markmaker/PushPullFeeder/README.md

# PushPullFeeder
All 3d-Printed Tape&amp;Reel Feeder



See [the blog](https://makr.zone/?p=399).

Electrolize-Regular.ttf: Copyright (c) 2011, Cyreal (www.cyreal.org) 
with Reserved Font Name "Electrolize" This Font Software is licensed 
under the SIL Open Font License, Version 1.1. This license is available 
with a FAQ at: http://scripts.sil.org/OFL

See also:
https://github.com/google/fonts/tree/master/ofl/electrolize
