markmaker/PushPullFeeder/(threads)

Thread 1 (2020-12-07):

Reel holder axel too tight

scott-t-wilson, 2020-12-07:
After some testing I've determined that my best value for 'axel_play' is 0.02mm, but the reel holder/counterpart axel is not affected by that parameter.

Looks to me like lines 2401-2 should be changed from:

    cylinder_p(d=reel_axle-2*reel_axle_wall,
        h=reel_width+reel_holder_thickness+6*e);

to

    cylinder_p(d=reel_axle-2*reel_axle_wall+axle_play,
        h=reel_width+reel_holder_thickness+6*e);

scott-t-wilson, 2020-12-07:
Created a pull request to make things easier if you decide this is an appropriate problem/solution.

Thread 4 (2021-07-05):

One of the 3D printed pieces is not used for anything?

brainstorm, 2021-07-05:
In the GIF animation from the README.md, the piece circled in red in this issue seemingly serves no purpose? Can you elaborate why it was (is?) used for?:

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

We were quite puzzled while putting the pieces together XD

/cc @cpgmoore

markmaker, 2021-07-05:
Hi @brainstorm

That's not normally used. I just added it to support the full EIA 481 standard. According to the standard, the reel (the hub) can be very wide. It seems they were often made from thick cardboard in the past. If the full EIA 481 width of the reel is used, then that counter nut and hanger thingy (image below) does not fit into the feeder slot width I wanted not to exceed.

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

You then have to rely on the reel being held on one side only and the next feeder keeping it from falling off. In that case, there is nothing holding the spent tape spool. **Then this little part comes into play.**

I frankly don't expect to encounter many reels that use the full width. But they do seem to exist, see here:

https://groups.google.com/g/openpnp/c/y1X3I8l31vM/m/DZQb2gLvAQAJ

_Mark

brainstorm, 2021-07-05:
Epic response, thanks Mark, good to know if we encounter those ;)

Closed 2021-07-05.

Thread 5 (2021-10-03):

Provide basic stl files for 8mm

noeldum, 2021-10-03:
Great project. It would be nice to provide some stl file for the basic setup in 8mm. That would make your project more accessible to all of us.

Opening openscad for the first time in my life and would prefer just printing it for testing before spending time to learn openscad.

Managed to get all parts in one stl but struggling to split them into several individual stl files.

markmaker, 2021-10-03:
Hi @noeldum

> Great project.

Thanks.

> It would be nice to provide some stl file for the basic setup in 8mm.

I don't think that'll work. You really need to adjust the play etc. for your printer/filament. That adjustment is the price you need to pay for it to work without using screws etc.

>  before spending time to learn openscad.

You don't really need to know OpenSCAD. You just set the parameters in the Customizer. Watch the video.

>Managed to get all parts in one stl but struggling to split them into several individual stl files.

You can enable individual parts there.

Sorry for the short answer, gotta go now.

_Mark

Thread 6 (2021-12-21):

Parametrized packing of pieces?

brainstorm, 2021-12-21:
I wish there was some sort of (randomized? parametrized?) bed area packing option in this PushPullFeeder to fit those components (other than the current two phase system)... I'm sure I can print all the pieces below on a [Replicator+ bed size](https://www.makerbot.com/3d-printers/replicator/) in one go? This one was so close!:

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

markmaker, 2021-12-22:
Hi @brainstorm
On my PrusaSlicr (Slic3r) I can let it break up the model and rearrange it.
_Mark

brainstorm, 2021-12-22:
True that, pity that Makerbot's software does not seem to have an (obvious?) "split" option like Slic3r does :-S

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

I'll go ahead and jump through that splitting w/ slicer and re-import the resulting stl to the Makerbot Print software.

markmaker, 2021-12-23:
Just out of curiosity. Can't you use Slic3r directly on the Makerbot printer? Does the slicer really need to be specific to the printer?

markmaker, 2021-12-23:
I just downloaded Slic3r to see what's the difference to PrusaSlicer and it seems day and night:

This is the result of the auto-arrange in Slic3r:

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

This is the result of the auto-arrange in PrusaSlicer:

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

**NOTE**: you need to switch to **Configuration / Mode / Expert** for the **Split to Objects** command to become available.

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

I recommend using PrusaSlicer, obviously ;-)

_Mark

brainstorm, 2021-12-25:
Thanks Mark for sharing your tests and tribulations! Very instructive and interesting as always ;)

The reason I was going for Makerbot alone was twofold:

1) I'm preparing the 3D print job for [an external service (I don't own that printer)](https://eng.unimelb.edu.au/telstra-creator-space/3d-printing-at-telstra-creator-space), so I just wanted to stick with their "Standard Operating Procedure" and settings to avoid any possible issues.

2) Since I might be iterating and submitting this job (or parts of it) in the future after some further tweaks, I thought about minimizing the steps (and third party programs) to go through for each iteration.

Also as a curiosity, I'm preparing the same job for another [makerspace](https://github.com/CCHS-Melbourne/) and Cura isn't good either packing the pieces together:

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

So given that every other slicer/software does or doesn't do it well, I thought about having it done on the OpenSCAD side instead, but of course I don't want to put that burden of you, this is pure fun/hobby ;)

markmaker, 2021-12-25:
I understand and yes, doing it right out of OpenSCAD _is_ the best option, that's obviously what I did for my Prusa printer too.

I don't think it will be possible to write a generic auto-layouter inside OpenSCAD (that's quite a hard problem anyways). Instead I would simply aim for a more compact layout that fits on these smaller print beds. The layout implemented now (for Prusa) has just evolved along with the model, there was no big effort into optimization.

I'll certainly accept a PR.  ;-)

I must say I'm a bit surprised that these print services have smaller print beds. I always thought the Prusa was one of the  smaller printers.

Another option might be somehow scripting / command-line controlling PrusaSlicer.

_Mark

brainstorm, 2021-12-27:
> I'll certainly accept a PR. ;-)

Challenge accepted ;)

I guess I'll start by tweaking that translate piece by piece (otherwise it takes too long to render and iterate on it):

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

I guess that after putting a few magic numbers in those `translates` by adding offsets there manually I might find a way to generalise this well, but I'm not too sure it can easily 🤔

brainstorm, 2021-12-27:
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

Getting there, I'll keep tweaking... thinking about the pieces, most of them parametrize by height (inset, chute, base plate), so the packing can be fairly static and benefit everybody without many constraints or breakage at all :)

t-paul, 2021-12-28:
I suppose I can't claim an unbiased opinion, but I'm not sure OpenSCAD is the right place to do that. The main argument being that usually the Slicer is the tool that understands the geometry and restrictions of the printer. And that is not necessarily just the bed size. Depending on the printer setup / fabrication method, there could be additional constraints or more relaxed options (e.g. the [3DPrintMill](https://www.creality.com/goods-detail/creality-3dprintmill-3d-printer) could just print all objects in a line).

I think a good option would be extended support for generating multiple parts in OpenSCAD and export those in file formats supporting that (e.g. 3MF). Now that is out of control of an OpenSCAD script at this point, so some added support in the script could be a good short term solution. I only want to highlight a possible more general option in case someone has suggestions on how to tackle those :grinning:.

brainstorm, 2021-12-28:
Always nice to have an OpenSCAD dev popping by (from https://github.com/openscad/openscad/issues/4022) :D

I hear what you say, my intention was to tighten the iteration loop while printing... out of curiosity, I exported the scad model to .3MF (supported in OpenSCAD), but apparently MakerBot print doesn't seem to accept it as-is (.3MF file is grayed out as opposed to .STL)?

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

What do you mean by "added support in the script"? Are there special OpenSCAD directives for .3MF exports?

t-paul, 2021-12-28:
Yes, if there's reasonable effort options in the script, that's certainly a quicker win. Bigger export changes in OpenSCAD probably will take some time, even though it's a topic coming up repeatedly and it would be an extremely useful extension, not just for 3MF.

I've never used the Makerbot tools, but if those do not support 3MF, that's a very sad situation. Especially considering 3MF is not a new format anymore (published in 2015) and Stratasys is listed as Steering Member of the [3MF Consortium](https://3mf.io/). I don't know, maybe they insist using their proprietary "Thing" format which I've never seen supported anywhere else.

brainstorm, 2021-12-28:
Did a quick search and no, they (Makerbot) don't support .3MF, I also think it's a bit of a shame: https://twitter.com/braincode/status/1475906583347429376

Anyway, thanks both for your valuable feedback, I think I'll call it quits with PR #7, @markmaker, you both have very good points on not doing this in OpenSCAD, I'll go with slic3r for now ;)

brainstorm, 2021-12-28:
Last fun bit... it takes some creative packing to print all pieces on the Ender 3 v2 (Pro) bed:

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

Closed 2021-12-22.

Thread 10 (2022-02-07):

Detect presence/absence of component in reel via CV to avoid chute jamming?

brainstorm, 2022-02-07:
The nozzle tip computer vision pipeline in OpenPnP has a nice feature where the camera can detect if a nozzle tip is present or absent in the "holding rack" via empty vs occupied images: https://github.com/openpnp/openpnp/wiki/Nozzle-Tip-Changer#vision-calibration

I know that there are mechanisms such as vacuum sensing to tell if a component has been picked up or not successfully by the nozzle tip, but I was wondering if the pushpullfeeders could have the **vision** reliability checks to avoid mis-picks and subsequent jamming towards the chute?:

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

OTOH, the feeder does not usually jam, but I guess that it might eventually jam given a big enough accumulation of components in some parts of the chute...

brainstorm, 2022-02-09:
> But if you have that condition, what happens in bottom vision? Are these cases not caught by the missing parts?

Oddly enough, the bottom vision does recognize resistors (by the bounding rectangle drawn around), but when there's a miss-pick and the bare nozzle looks at the bottom camera, the Job continues as if everything was fine and it tries to place even when there's no resistor to be placed :/

/cc @PancakeLegend

markmaker, 2022-02-09:
That's odd. It should definitely not happen. Pipeline?

markmaker, 2022-03-11:
I think we agreed that the problem should be detected in the alignment, so I can close this here.
_Mark

Closed 2022-03-11.

Thread 9 (2022-02-07):

Adding more wings to the friction wheel affects spool fitting?

brainstorm, 2022-02-07:
The orange wheel has more edges than the simple hexagon of the first two blue and red friction wheels:

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

Therefore the previously printed spools do not have an optimal fit... although they coincidentally work fine, I just wanted to report this since I think it's a bug... the nut that locks with the spool should be an hexagon, independently of the number of wings from the friction wheel, IMHO.

In other words, adding more wings to the wheel would make the wheel-to-spool interface more unreliable since it'd eventually converge towards a circumference which could slip... keeping the hexagon shape irrespective of the number of wings would help.

Also, spoiler, the latter one is the difference of getting our feeders to work properly without retractions or not. The amount of wings on the orange piece is the one that makes our feeders work the most consistently with 0603 component reels.

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

markmaker, 2022-02-07:
Just also wanted to add that I'm well aware that the reliability of the friction wheel is the Achilles heel of the whole feeder. Each filament change required me to adapt its settings. I always managed to get it working, but it is definitely not "print and forget".

Anything to make it better is highly welcome. 👍👍👍

brainstorm, 2022-02-09:
I'll try to carve out some time and fix this hexagon issue, but it's actually not too critical, the wheel holds in place fine for now because the tolerances are good enough (for the testing we've been conducting so far and the use they've seen).

@PancakeLegend was theorizing on using magnets instead, but I'm not exactly sure how that'd work plus it introduces non-3D printed parts, which is not as practical as a fully 3D printed feeder.

OTOH a redesign/version of this feeder for laser cutting would be amazing because it'd cut down the manufacturing time greatly, but I massively digress here X"D

Closed 2022-07-30.

Thread 12 (2022-03-10):

Adjusting width of tape inset slot

infinitemachinery, 2022-03-10:
The slot for the tape in the tape inset is too snug in width. Some of the 8mm tapes I have will not even fit. What would be the correct parameter to adjust to slightly increase the width in the inset? Tape_width is not the one, as that appears to only be for the standard sizes 8,12,16, etc.

markmaker, 2022-03-11:
Hi @infinitemachinery

You're right, there isn't an actual parameter for that. It was never a problem so far, as the inset is one-sided and when pushing it to the body, I was able to make it a bit more or less tight.

But I see the need and I'll add it.

_Mark

markmaker, 2022-03-11:
See #13.

Closed 2022-03-11.

Thread 17 (2023-02-01):

Parts don't fit

tufelkinder, 2023-02-01:
I exploded this into parts using the OpenSCAD and printed it on my Original Prusa and none of the parts fit together. I pounded a couple together to make them fit and ultimately they just broke off. What am I likely doing wrong...?

markmaker, 2023-02-01:
Hi @tufelkinder

Please watch the video:
https://youtu.be/cNCjjvCT4Fc

Especially the part about adjusting the play using the test print:
https://youtu.be/cNCjjvCT4Fc?t=78

This project makes it a _design goal_ not to require screws, springs etc. so everybody can just print it without ordering parts. But this only works if you adjust the play to your printer, filament and settings.

_>  ultimately they just broke off_

Just in case you missed this: this project was developed for PETG, it will certainly **not** work with PLA.

See also here about the goals and features:
https://makr.zone/new-all-3d-printed-tapereel-feeder/399/

_Mark

tufelkinder, 2023-02-01:
Thank you, hadn't seen this Youtube video previously, so that's obviously very helpful.

For what it's worth, they broke off under extreme pressure and strain to connect and move the pieces. Still, I can look at switching to PETG.

markmaker, 2024-11-17:
I am closing this for now. If issues remain, we can always reopen it.

Closed 2024-11-17.

Thread 18 (2024-10-20):

New LumenPNP Needs Notch

AmeNote-Michael, 2024-10-20:
The new LumenPNP with their electronic feeders have added a backing positioning plate for their feeders to match their electronics. This adds requirement for a notch in the mount.

Love your PushPull Feeders. I am just tuning to use with my LumenPNP and look forward to having all my components on feeders. Strip feeders are just a pain and although I have a bunch of the LumenPNP feeders, I cannot afford for every component.

Could you add option for notch to support the new mounting of the LumenPNP. The image provided hopefully gives you all details needed for the notch. I am glad to test print and fit.

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

AmeNote-Michael, 2024-10-20:
By the way, the dimensions provided are in mm.

AmeNote-Michael, 2024-10-20:
For overhang, you will likely need to print in supports that need to be cut out.

AmeNote-Michael, 2024-10-20:
Just realized I could provide you the overall dimensions of the additional tabs on back of 2020 x member. It is 5mm deep by 5mm wide.

markmaker, 2024-10-20:
See #19 for a combined answer.

_Mark

markmaker, 2024-11-17:
See #19.

Closed 2024-11-17.

Thread 19 (2024-10-20):

Lever does not position on build Plate when subtract from extrusion mount edge

AmeNote-Michael, 2024-10-20:
To use LumenPNP existing extrusion mount, the extrusion mount edge y needs to be changed to -35. Doing so causes the default build plate print postion for the Lever to be inside the base part. Simple to fix by rendering seperately, but would be nice if can just generate.

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

markmaker, 2024-10-20:
Hi @AmeNote-Michael,

this answer includes #18.

Unfortunately, your -15mm adjustment of **extrusion mount edge y** is way more than I ever anticipated. As you see it also renders the tape chute cutout wrongly, i.e., it would be blocked like that we would need to improve from the simplistic way it is currently done. Maybe you don't want the chute at all, then we would need a way to disable it entirely, so it won't do the cutouts at all, and waste print time.

Trying to reconstruct your case, I also have problems with the lock lever cutouts (cut in two). You somehow seem to have overcome this, by adjusting more params, right? I fear such large changes would require many test-prints and much tuning until everything is peachy again. I'm not saying it can't be done, but you would need to be ready to invest that kind of time, effort and filament.

Making the base so much larger will also increase your print time per feeder significantly. I spent an eternity making everything as small as possible to bring it down.

Furthermore, I doubt you'll make it still fit one standard print platter, which is an important design goal too. Maybe if you leave out the chute, but then the design is not really complete, i.e., while you might be happy with this, the next user might not (which taints this option in the "Open Source" spirit a bit).

Your #18 requirement adds more problems to these. Including, as you guessed, need for 3D printing supports, which were entirely avoided in the main design so far. Again much thinking went into how to achieve that.

With #18 you also force the feeders to align with the notches. I haven't found specs, but assume the feeder is quite wide if a 12mm option exists with the same notches. If the push-pull feeders are narrower at their < 16mm, you'll waste space, i.e., the number of feeders you can add. And you'll lose some stability. The feeders are thought to really snuggle close to each other to add stability and to dampen some vibrations.

All-in-all I'd like you to consider another option:

Seeing the Lumen has two feeder banks, you could dedicate one to PushPullFeeders, or even just a part of one. Then mount another 20x20 V-slot extrusion on top of the feeder rail. Just some holes through it and then [drop in tee nuts](https://openbuildspartstore.com/drop-in-tee-nuts-pack/) in the lower rail, and screw down (countersunk).

This will even add to the stability of the frame. Vibrations from the push-pull actuation are a potential problem with 0402 parts, I needed to support my 20x20 extrusion every ~200mm for it to work all across.

Finally mount the mostly unmodified, proven PushPullFeeder on top. Given your -15mm Y adjustment, I assume you'll get a +5mm pick Z. This is not super-optimal, but still okay. With some careful tuning it could probably be reduced down a few millimeters.

You can always remove the extrusions on top, e.g. once you can afford more electric ones. With the drop in tee nuts, nothing is permanently modified or damaged on your machine.

What do you think?

_Mark

AmeNote-Michael, 2024-10-20:
Mark, thanks for quick reply. I had considered your option and looked into getting the materials as you suggested. I was thinking the bounce might be an issue, but your suggestion of several t bolts is a good idea. Will look at that. I am planning to use rear feeder bar for electronic and front feeder bar for push pull. Leaves a small build plate though, especially with my version of LumenPNP. Going to look into if I can mod mine to the latest version from Lumen which mounts the air pumps and electronics on side.

I like the idea of having a mix of feeders, depending on project. Use the Lumen feeders for components that exist pretty much everywhere, but use the push pull for even components you may originally consider only in strip feeders.

Need to complete builds of a current job I have on device and then looking forward to experimenting. Using this time to print a bunch of feeders.

Will go with adding additional bar as you suggest.

Thanks.

markmaker, 2024-11-17:
I'm closing this for now. We can always reopen, when needed.

Closed 2024-11-17.

Thread 21 (2024-11-16):

friction_wings variable used instead of hex_face to build the spool left

uncle-buzz, 2024-11-16:
I found an issue with the number of faces of the friction wheel and the spool left that uses the number of wings instead of the number of faces, so creating a friction wheel with 7 wings and 6 faces will build a spool left with 7 faces, I replace the friction_wheel variable with the hex_face at line 3018 and the build is now conform, sorry I don"t know how to propose a PR :
`                   union() {
                        translate([0, 0, -e]) {
                            beveled_extrude(height=spool_wall_left+2*e, bevel=bevel_z, angle=135) {
                                circle_p(d=friction_hex_diameter,
                                    $fn=hex_face);
                            }
                        }
                    }`
instead of
`                   union() {
                        translate([0, 0, -e]) {
                            beveled_extrude(height=spool_wall_left+2*e, bevel=bevel_z, angle=135) {
                                circle_p(d=friction_hex_diameter,
                                    $fn=friction_wings);
                            }
                        }
                    }`

markmaker, 2024-11-17:
Hi @uncle-buzz,

> so creating a friction wheel with 7 wings and 6 faces will build a spool left with 7 faces.

I was unable to reproduce that. Both are built with 7 faces. As far [as I see in the code](https://github.com/search?q=repo%3Amarkmaker%2FPushPullFeeder%20%24fn%3Dfriction_wings&type=code), the matching part also has the `$fn=friction_wings` shape. This also shows in the preview:

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

Of course, if you change the parameter **friction wings**, you need to _reprint_ the **spool left** to match it.

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

I agree it is a bit confusing to still call this "friction_hex" in the code when it is no longer hexagonal once you change the number of wings. And having to reprint the  **spool left** is also not optimal.

So I would accept  PR that changes it _everywhere_ (also needs to be changed in the `friction_hex_diameter` calculation). Are you sure you can't learn how? It is a liberating feeling to be able to contribute :rocket: :smile:

_Mark

uncle-buzz, 2024-11-17:
My bad, checking the code on GitHub shows there is no hex_faces variable in your file, I probably added it to add wings without changing the number of faces and forgot to use this new variable for the spool left...
The bug exists only in my files because I created it. Sorry
I dealt with it a few months ago, but I have forgotten it...

Closed 2024-11-19.
