markmaker/PushPullFeeder/(commit log)

2020-04-12 Initial setup.
    [PushPullFeeder.scad]
2020-04-12 Improved Customizer of tape specs.
    [PushPullFeeder.scad]
2020-05-20 Bugfix: inverted play on tape chute knob.
    [PushPullFeeder.scad]
2020-12-08 Added 'play' to reel counterpart hub
    [PushPullFeeder.scad]
2021-12-29 Remove an inlier polygon point in the extrusion_mount_2D(). The tensi… (#8)
    * Remove an inlier polygon point in the extrusion_mount_2D(). The tensions was not accounted for (the extra corner point is not actually needed).
    [PushPullFeeder.scad]
2022-03-11 Added tape_width_adjust.
    The new tape_width_adjust can change the nominal tape width +/-0.25mm.
    It will only affect the tape inset, i.e. one need only (re)print the
    inset to be tape specific.
    However, in order to support seamless tape transport, the tape chute was
    also adjusted to the maximum tape_width_adjustment = +0.25mm. This in
    turn affects the base plate, where the counter-shape is now shallower.
    [PushPullFeeder.scad]
2022-07-29 Added pick position offset option
    [PushPullFeeder.scad]
2022-08-02 Optimized spent tape chute when using a wider extrusion with pick offset
    [PushPullFeeder.scad]
2022-11-30 Added axle_groove_tension variable.
    Added parameter axle_groove_tension for adjusting the tension for the spool axle end clip.
    [PushPullFeeder.scad]
2024-11-09 avoid spent tape chute printing bridge
    [PushPullFeeder.scad]
